nyanekere/GTXR-Mini-Motors-Project/Mini Motors DRM.pdf

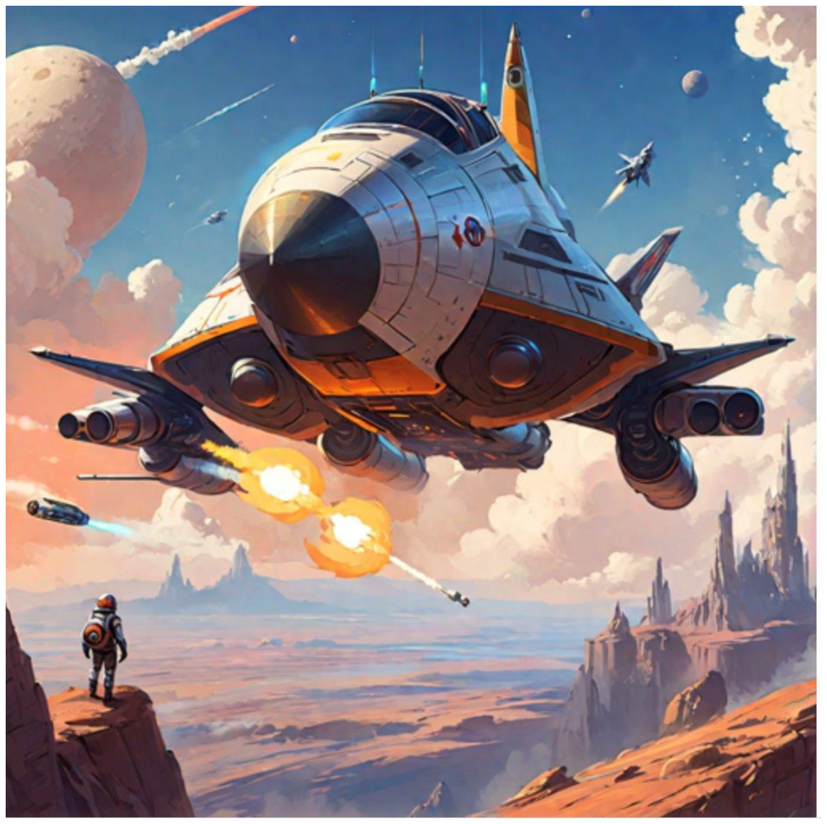
[picture p1: figure]

# Mini Motors DRM – Ride My Rocket

Vedanth Jonnalagadda, Nishu Anekere, Aryan Thacker, Gurnek Singh

# DRM Overview

- Motor Design Requirements
- Major Trades
- Motor Specs - MATLAB Simulation
- Forward Closure
- Head-End Ignition
- Casing
- Nozzle
- Full BOM
- Questions

# Mission

- Create an N-class solid rocket motor design that innovates in terms of retention method, ignition method, and nozzle design to serve as a testbed for future GTXR motor designs.

# Design Requirements

- N-Class Motor
- Maximum Possible Impulse
- Novel Designs: Graphite Nozzle w/ Aluminum Jacket, Head-End Ignition
- In-Depth Analysis
- Good Documentation
- Maximize Wet Mass : Dry Mass Ratio
- Cost < 2k

# Major Trades

- Nozzle: Considered copper, steel, and graphite
oOne-piece nozzle: Chosen for continuity
- Retention Methods: Tried instant pot method, now using radial bolts
- Ignition: Considered black powder
oChose flash powder: larger flame, burns longer

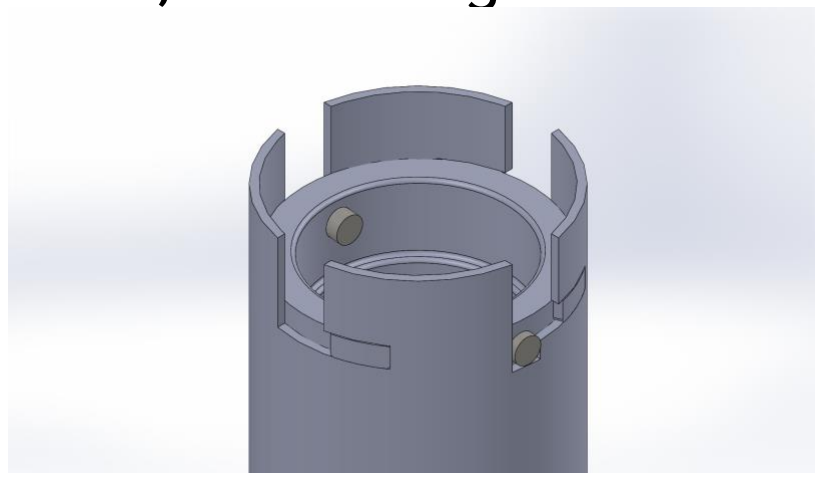
[picture p2: figure]
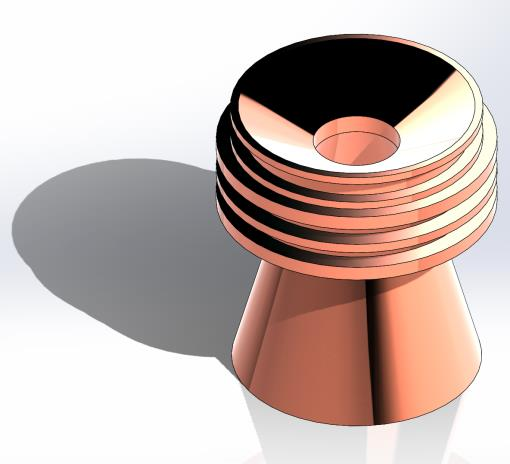
[picture p3: figure]

# Motor CAD Assembly

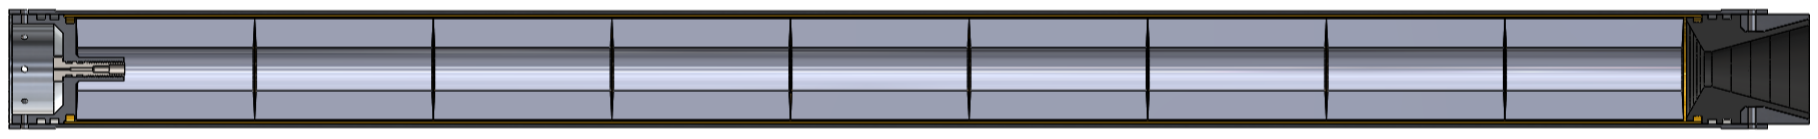
[picture p4: figure]

## Motor Geometry + Specs

- 9 Grains, OD 3.7in
- Total Impulse: 4603 lbf*s
- Max Thrust: 971 lbf
- MEOP: 666 psi
- Propellant Mass: 20.4 lbm

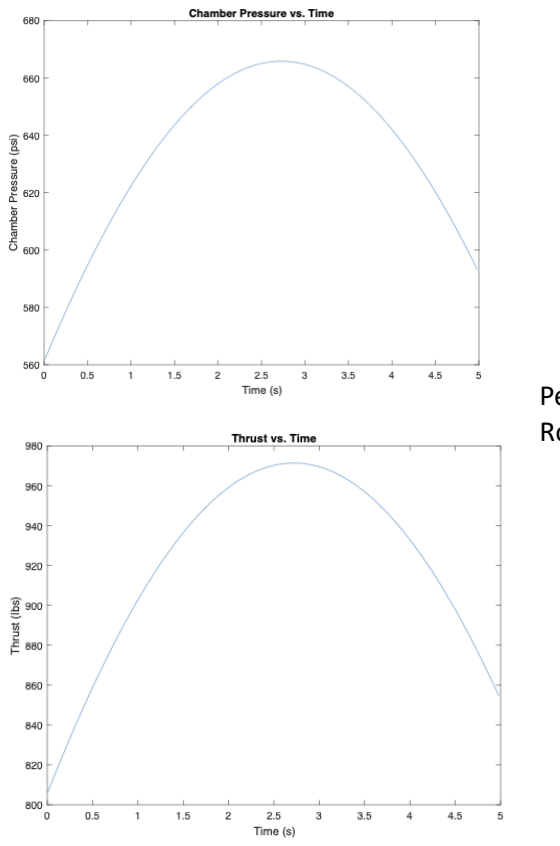
[picture p5: figure]

Peak Ride my
Rocket Team

Maximum Impulse specs generated with optimization script. N-Motor max impulse can be 4604 lbf*s

# Forward Closure – Overview, CAD

## - Design requirements create a high-pressure

seal to withstand extreme pressure.

## - Holes for Pressure Transducer and Igniter

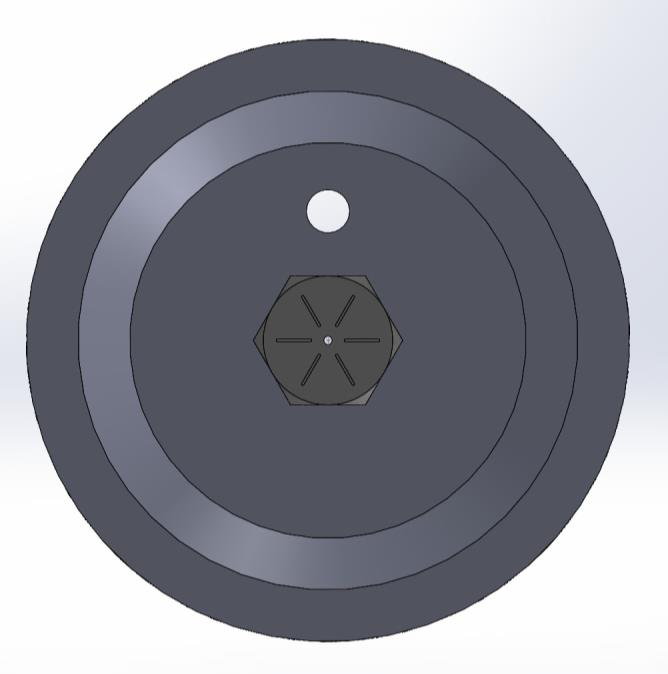
[picture p6: figure]
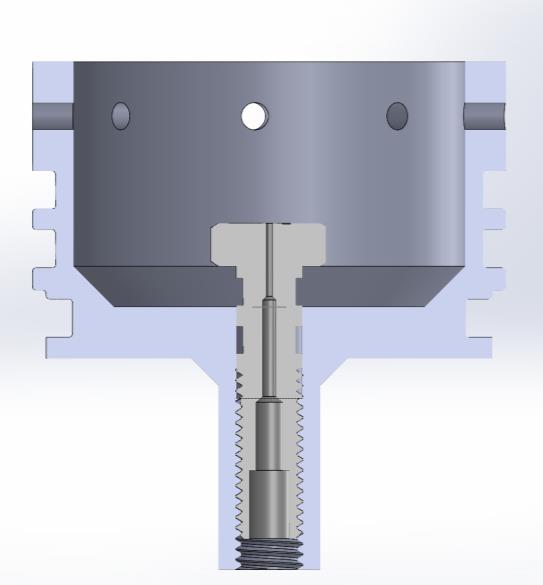
[picture p7: figure]
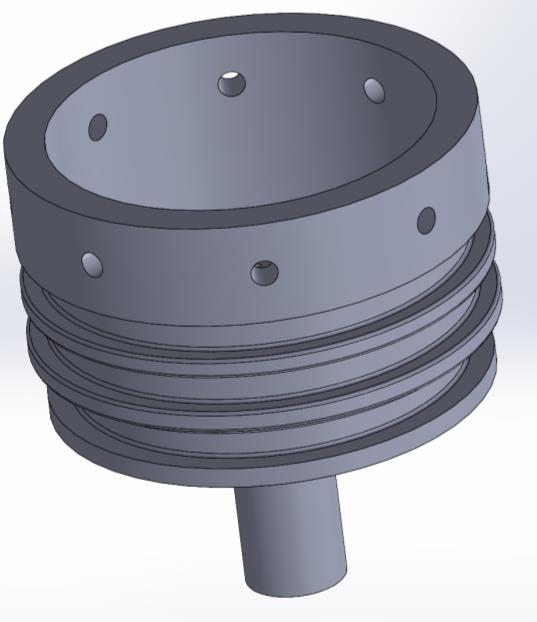
[picture p8: figure]

# Forward Closure – Analysis/ Risk

- Plate Thickness: 0.375 in
oFOS = 2.32
- FWD. Closure Plate stress: 16370 psi
- FOS = 2.3
- 8 Bolt Shear Stress: 727 psi per bolt
- FOS = 9
- Risks

oOverheating leads to the O-rings melting, might lead to leaks

# Forward Closure – Ansys

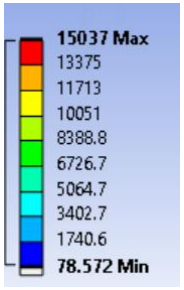
[picture p9: figure]
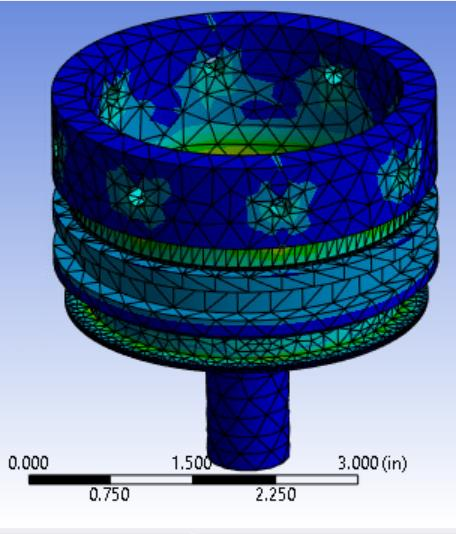
[picture p10: figure]

- Ansys Static Structural
- 5791.6 lb force acting
upwards on bottom face
- Pin holes as fixed
surfaces
- Tensile Strength of Al
6061-T651: 38,000 psi

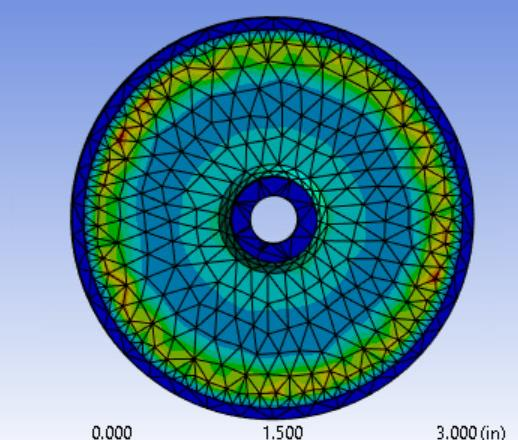
[picture p11: figure]

# Forward Closure – Manufacturing/Integration

- Manufacturing Plan: Simple lathe operations with milling holes and tapping holes
- Grains & thermal liner can be loaded from the top, bolts are used to fasten closure

# Head-End Ignition - Overview

- Design Requirements:
oCreate an igniter that can safely and effectively ignite the motor from the head
oThe igniter must hold back the pressure of the motor and be reusable

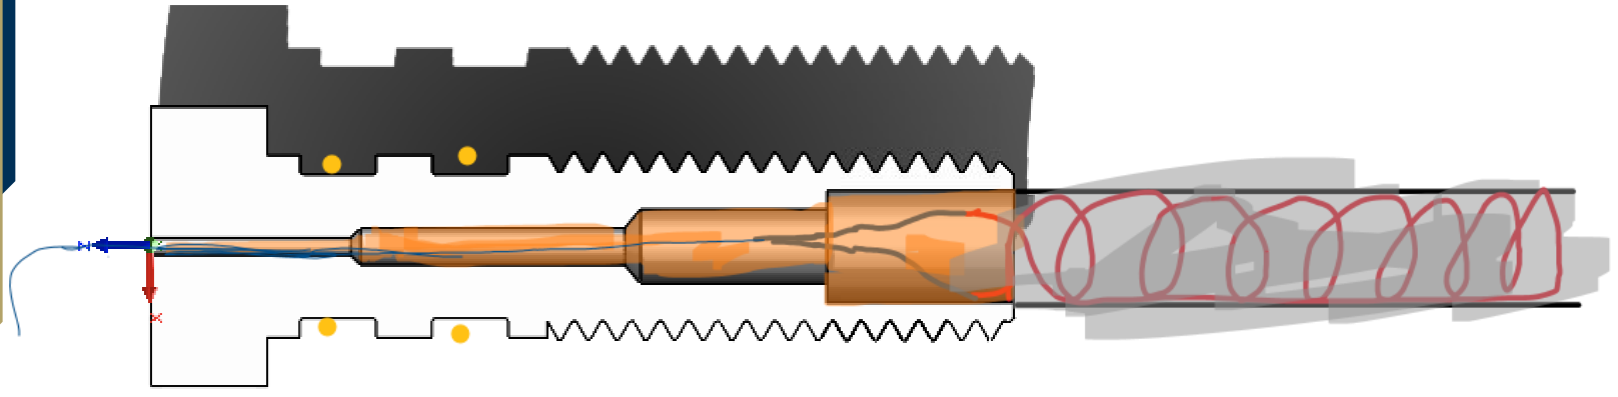
[picture p12: figure]

# Igniter Testing Plan

1. Mix Flash Powder + Quick Setting Epoxy to create sturdy clump
- Flash Powder burns hot and fast while epoxy burns slow
- 60% Potassium Nitrate
- 30% Aluminum Powder
- 10% Sulfur Powder
2. Apply mixture to igniter bolt with nichrome wire wrapped around mesh
3. Adjust flash powder amount increase flame length, wrap nichrome wires and run around 3 amps to ignite.
4.We choose the recipe that generates the greatest flame length and quickest ignition time

# Head-End Ignition – Manufacturing

- Manufacturing, Simple lathe operations on a COTS bolt
- Attach steel mesh to the inside bolt using epoxy
- Wrap Nichrome wire around mesh and attach to another wire that will pass through the tiny hole. Mix the flash powder epoxy and coat onto mesh.

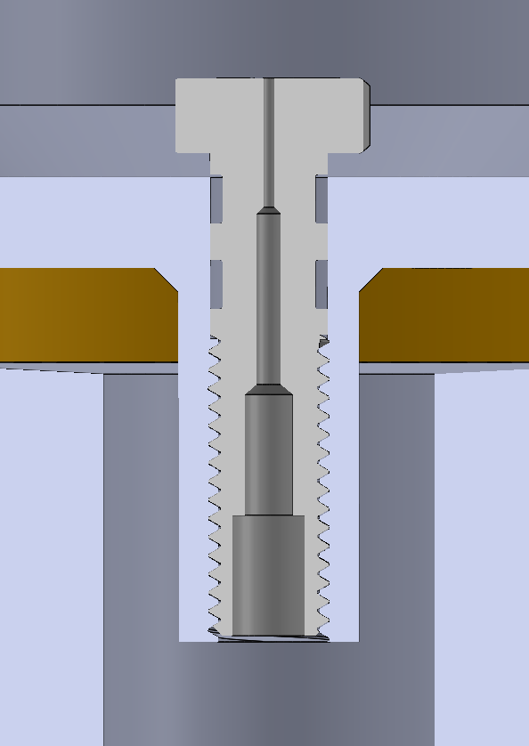
[picture p13: figure]

# Head-End Ignition – Analysis & Risks

- Threads rated for 150,000 psi; Two O-rings rated for 400C
- Nichrome Wire requires 4.5 amps to raise temp to 500C
- The RTV silicone is rated to handle 350 psi, however, based on our design, the silicone should push up against the walls of the bolt since they converge.

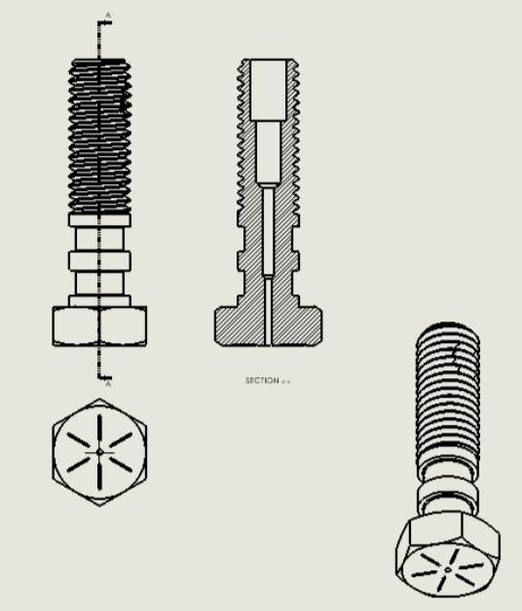
[picture p14: figure]

# Casing – Overview

- Design requirements: contain all the grains, while containing high pressures
- High temp at thermal liner edges lead to vulnerabilities
- Casing Wall Thickness = 0.1" and 0.15" around holes

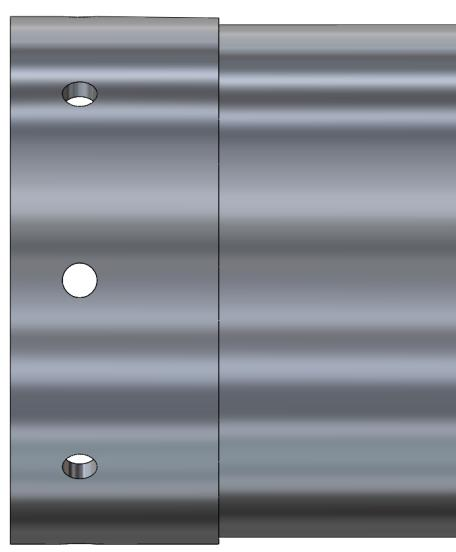
[picture p15: figure]

# Casing – Analysis & Risk

- Hoop Stress: 11700 psi
- FOS = 3
- Longitudinal Stress: 5800 psi
oFOS = 6
- Bearing Stress : 18900 psi
- FOS = 2

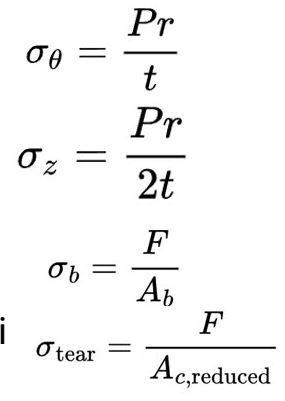
[picture p16: figure]

- Tear-through stress: 3900 psi
- FOS = 9
- High temp at thermal liner edges thermal liner lead to vulnerabilities

# Casing - Manufacturing

- Manufacturing: Lathe OD down and add radial holes with Mill

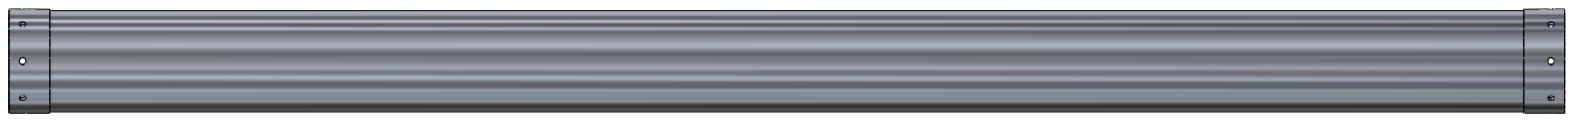
[picture p17: figure]

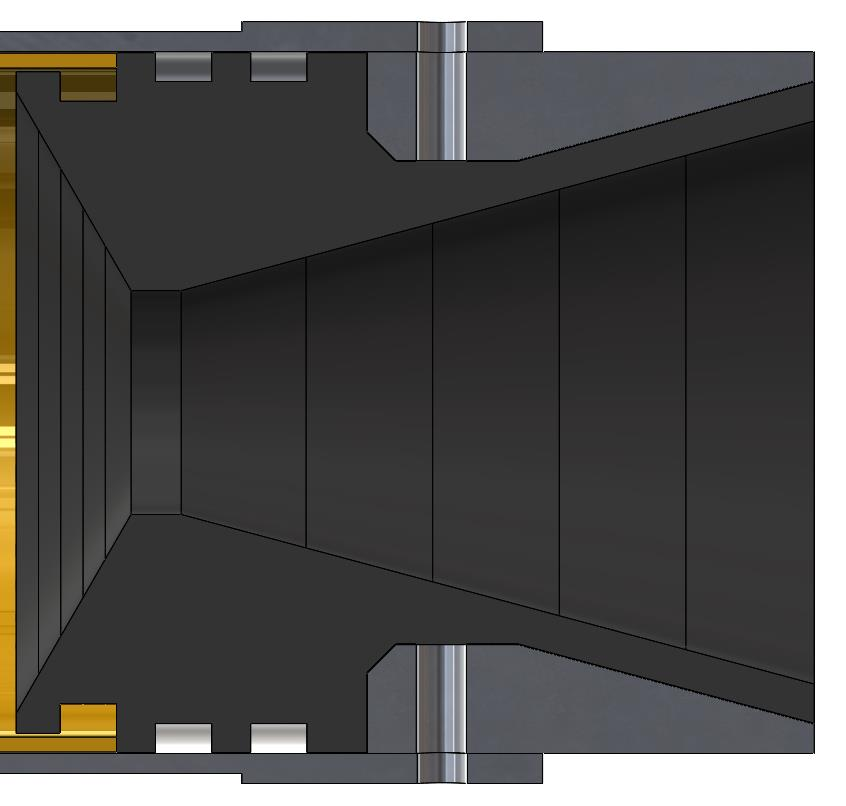
[picture p18: figure]

# Nozzle - Overview/Risks

- Two-Part Nozzle – insert CAD
oFull Graphite Contour
oAluminum Jacket w/ Radial Bolts
- Jacket is cut in half to insert onto the nozzle
- Liner Interface
- Risks
oAluminum Melting
oGraphite Cracking

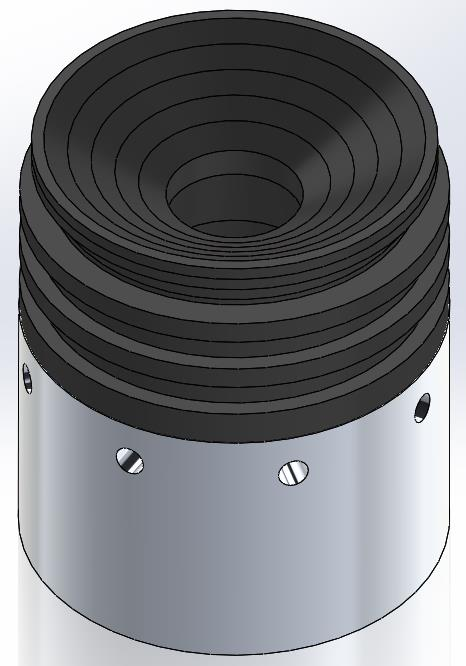
[picture p19: figure]

# Heat Transfer Methodology

- Bartz Equation [1] gives heat transfer coefficient and is accurate for nozzle heat transfer as per NASA paper + Connor has used it before
- Wrote code to graph h_g vs. Nozzle Distance + pulled properties from CEA and Nozzle Geometry
- Input heat transfer coefficient into ANSYS

## Verifying Heat Transfer Code w/ NASA Paper

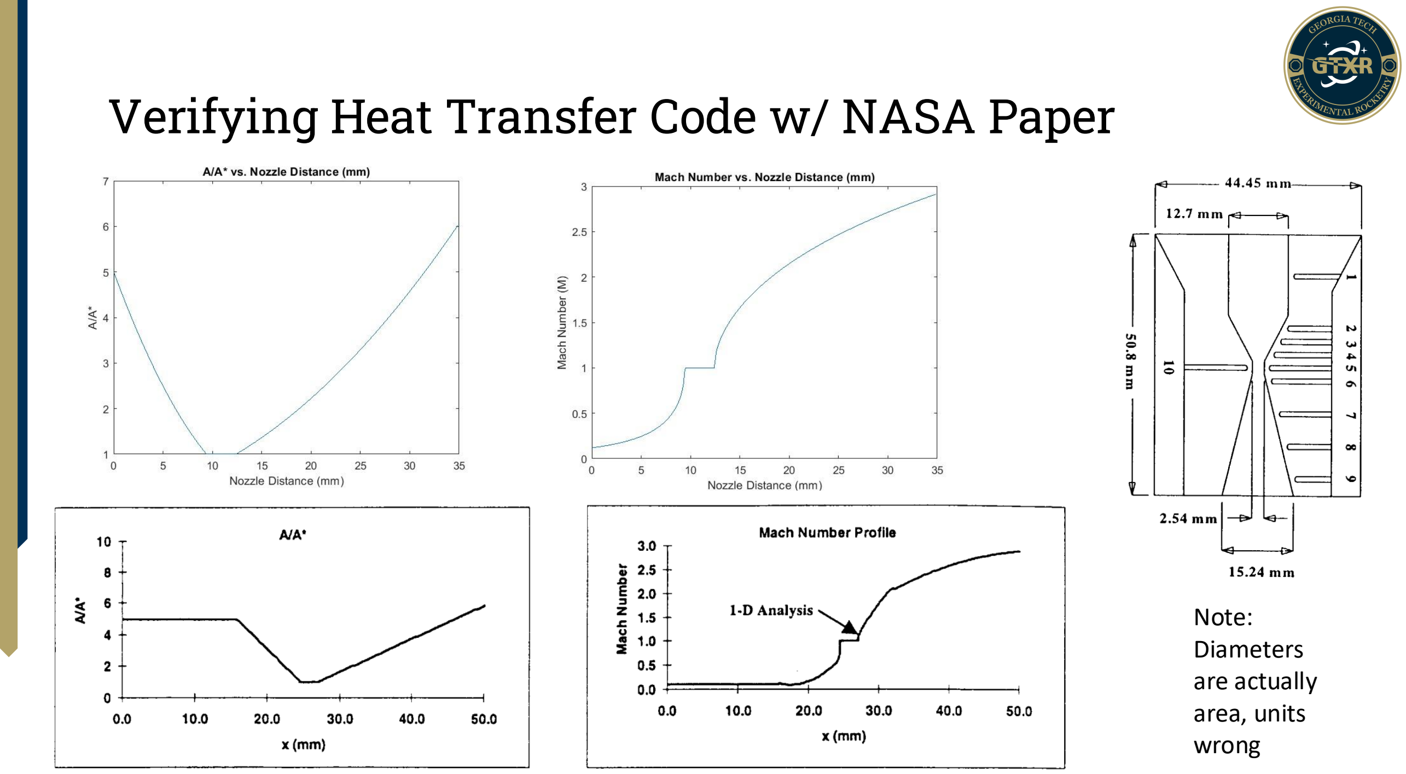
[picture p20: page 21]

Note:
Diameters
are actually
area, units
wrong

# Verifying Code (cont.)

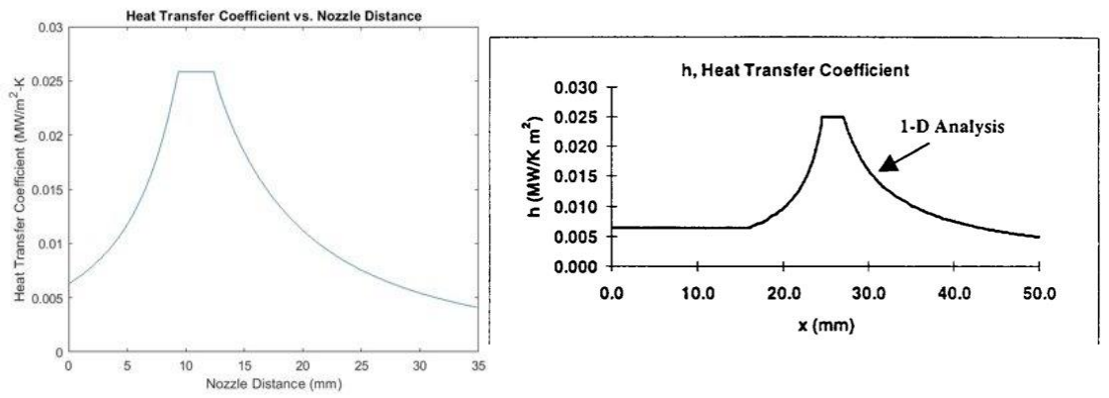
[picture p21: figure]

## Heat Transfer Graphs

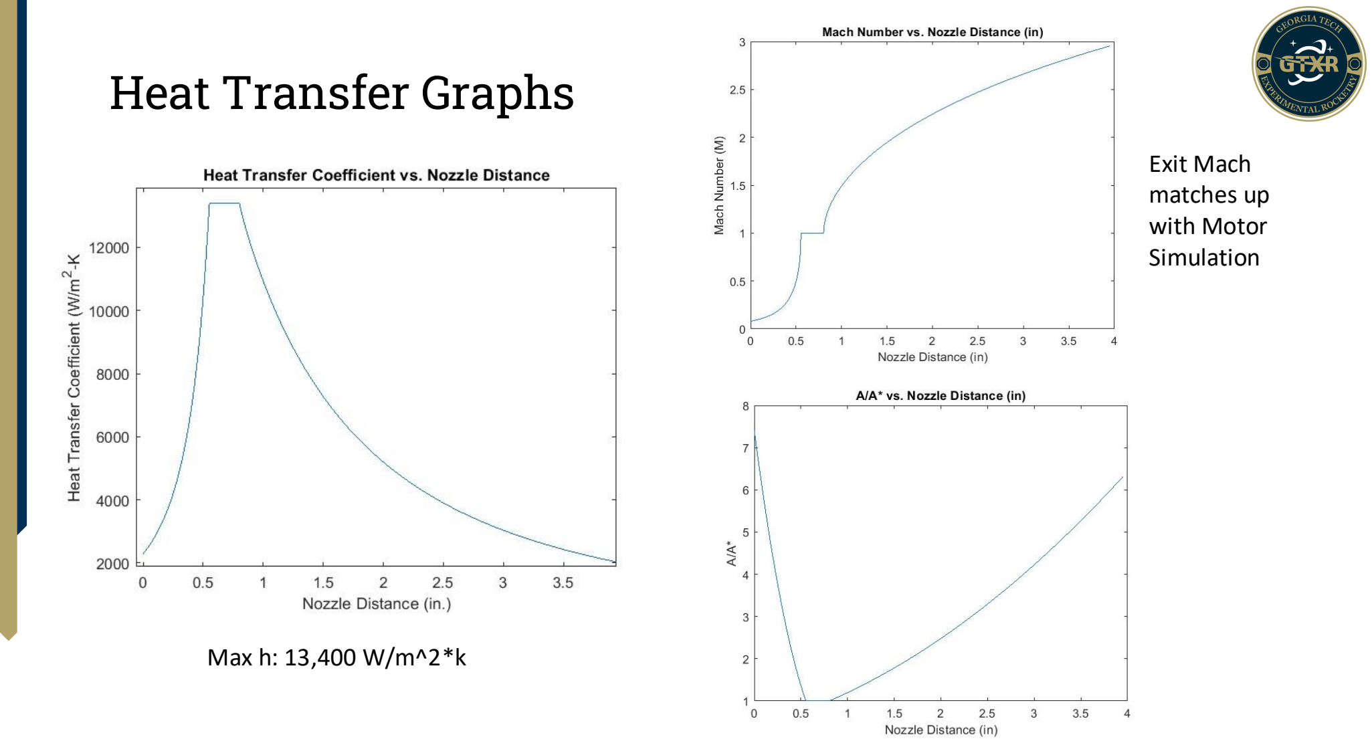
[picture p22: page 23]

Max h: 13,400 W/m^2*k

Exit Mach
matches up
with Motor
Simulation

# Nozzle – Analysis (Transient Thermal)

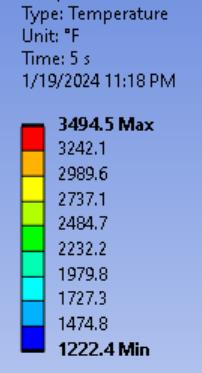
[picture p23: figure]

- Heat transfer into nozzle: mainly convection, others ignored
- ANSYS Transient Thermal Analysis
- Boundary Conditions: Sliced nozzle,
took weighted avg's of corresponding
sections of Heat Transfer Coeff. Vs. Nozzle Distance and assigned to each slice
- Graphite Melting Temp: 5000 F
- Aluminum Melting Temp: 1221 F

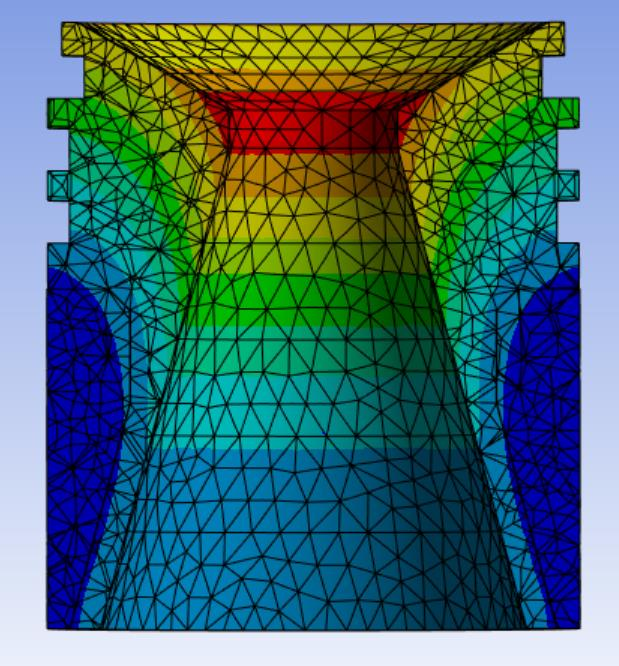
[picture p24: figure]
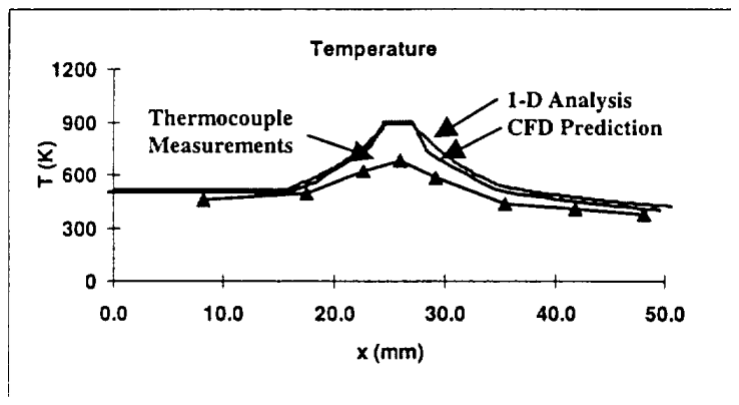
[picture p25: figure]

# Nozzle – Analysis (Structural Analysis)

- ANSYS Structural Analysis – Nozzle Compressive + Hoop Stresses
- Max stress disregarded (bad mesh around
bolt holes)
- Nozzle Ring Bearing Stress
- Bolts Stresses
- Graphite Nozzle FOS = 1.9 ~ 2
- (Compressive Yield Stress)
- Aluminum Jacket FOS = 11.8
- (Tensile Yield Stress)

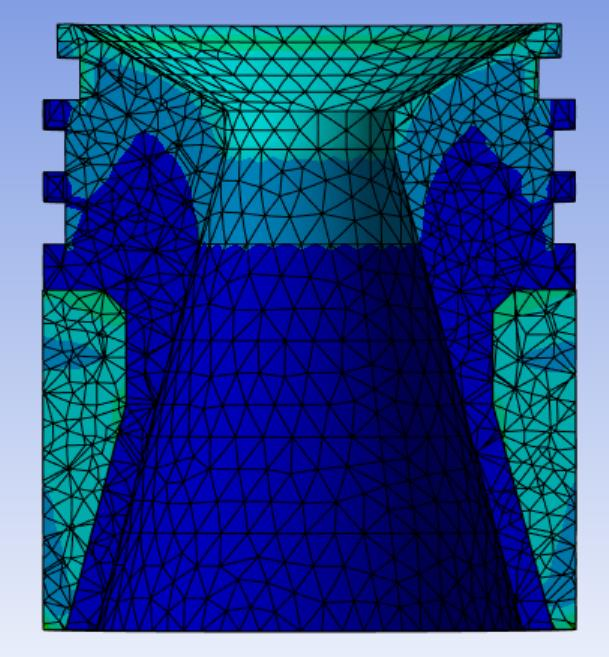
[picture p26: figure]
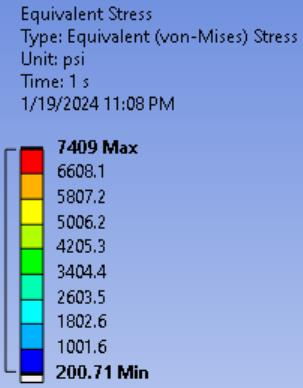
[picture p27: figure]

# Nozzle – Manufacturing/Integration/Cost

- Graphite Contour can be manufactured with a Lathe
- Aluminum Jacket can be manufactured with the Lathe, Mill, and Wire EDM or Waterjet
- Clamp both pieces of the Aluminum Jacket onto the graphite, slide into motor, attach bolts

# Motor BOM

- Full Cost- $623
- Fwd. Closure Cost : $80
- Igniter Cost :$170
oCasing Cost - $260
oNozzle Cost - $130
- Link to full BOM (https://gtvault.sharepoint.com/:x:/r/sites/ridemyrocket/_layouts/15/Doc.aspx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)

# Closing Remarks

- Shoutout Andrew for answering all our questions and Connor for helping with the heat transfer!
- All CAD, calculations, graphs, trade studies found in
our SharePoint (https://gtvault.sharepoint.com/sites/ridemyrocket/Shared%20Documents/Forms/AllItems.aspx)
- Why should we be picked?
- Novel Nozzle, Igniter Desings
- Maximum Impulse for N-Motor
- In-Depth Analysis
- Cheap

# Questions?

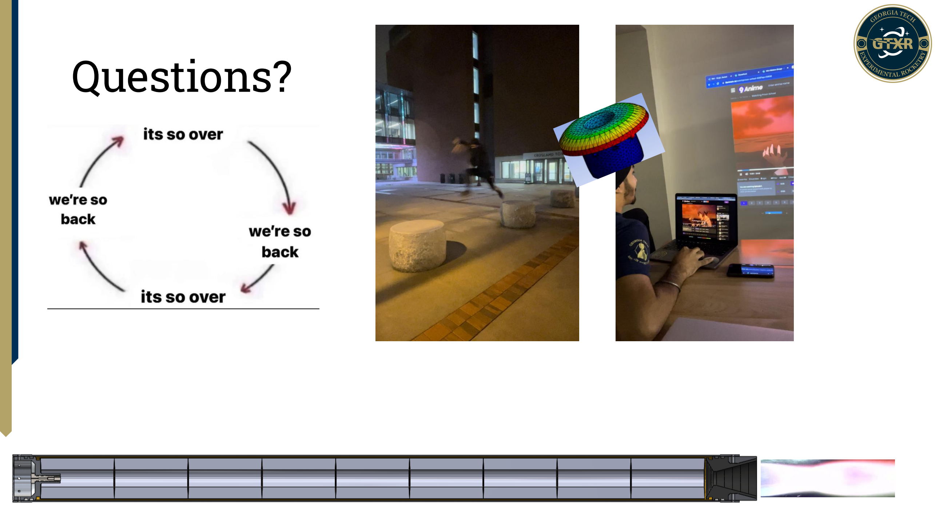
[picture p28: page 29]

# References

- Nozzle Heat Transfer NASA Paper -https://ntrs.nasa.gov/api/citations/19990025912/downloads/19990025912.pdf (https://ntrs.nasa.gov/api/citations/19990025912/downloads/19990025912.pdf) [1]
