nyanekere/GTXR-Mini-Motors-Project/Copper Nozzle V2 (7).SLDPRT

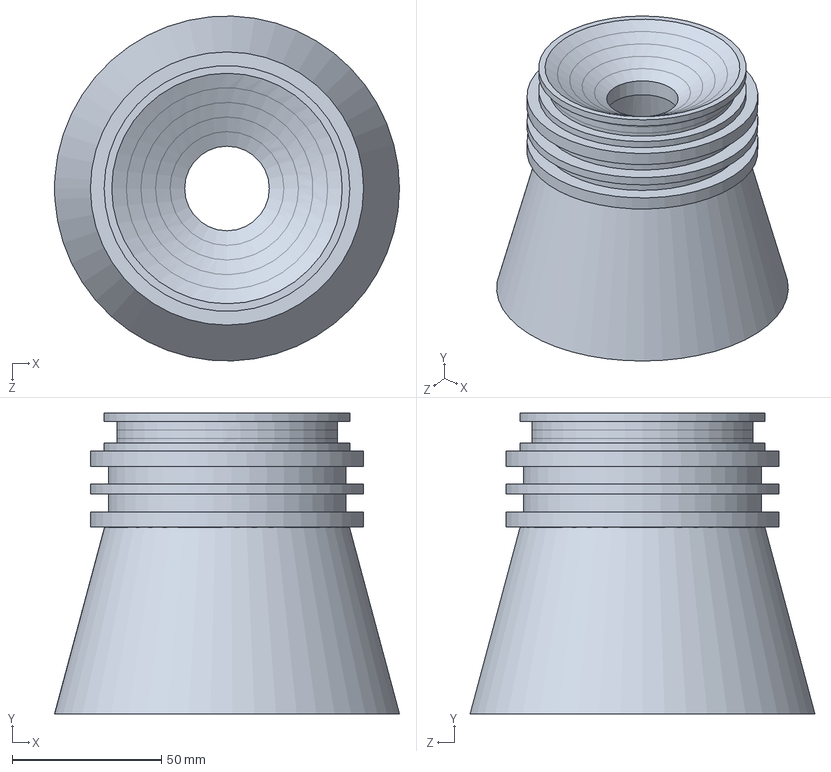
[picture p29: CAD file, 2025-10-03]
Copper Nozzle V2 (7).SLDPRT
115.5 x 100.6 x 115.5 mm
