nyanekere/GTXR-Mini-Motors-Project/Copper Nozzle Cavity.SLDPRT

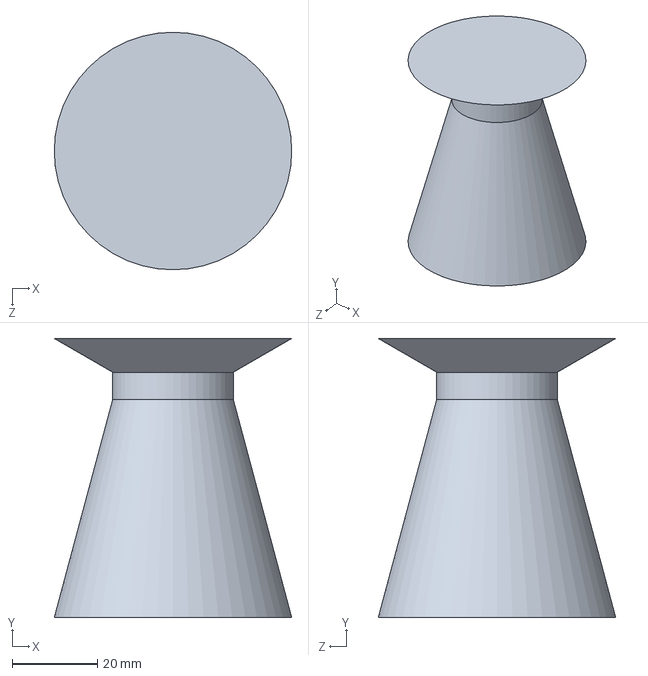
[picture p30: CAD file, 2025-10-03]
Copper Nozzle Cavity.SLDPRT
55.9 x 65.6 x 55.9 mm
