nyanekere/GTXR-Mini-Motors-Project/Nozzle Heat Tranfer ANSYS Results (Screenshots).pdf

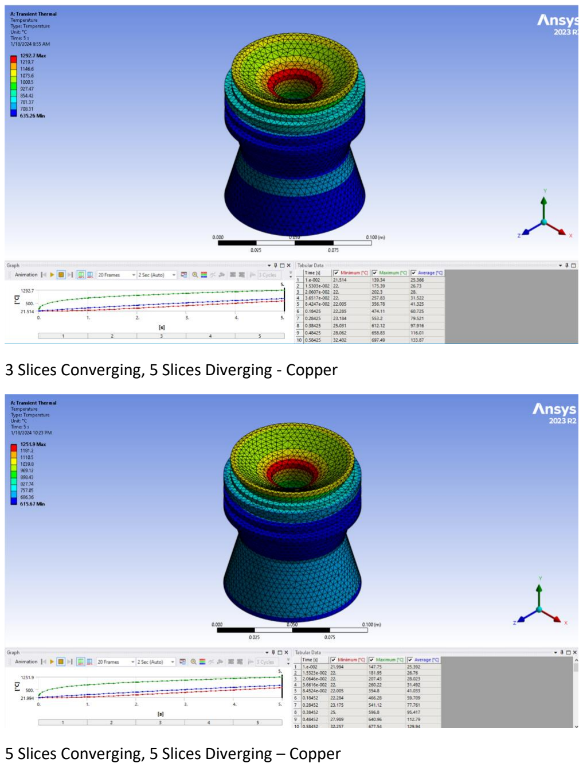
[picture p31: page 1]

3 Slices Converging, 5 Slices Diverging - Copper

5 Slices Converging, 5 Slices Diverging – Copper

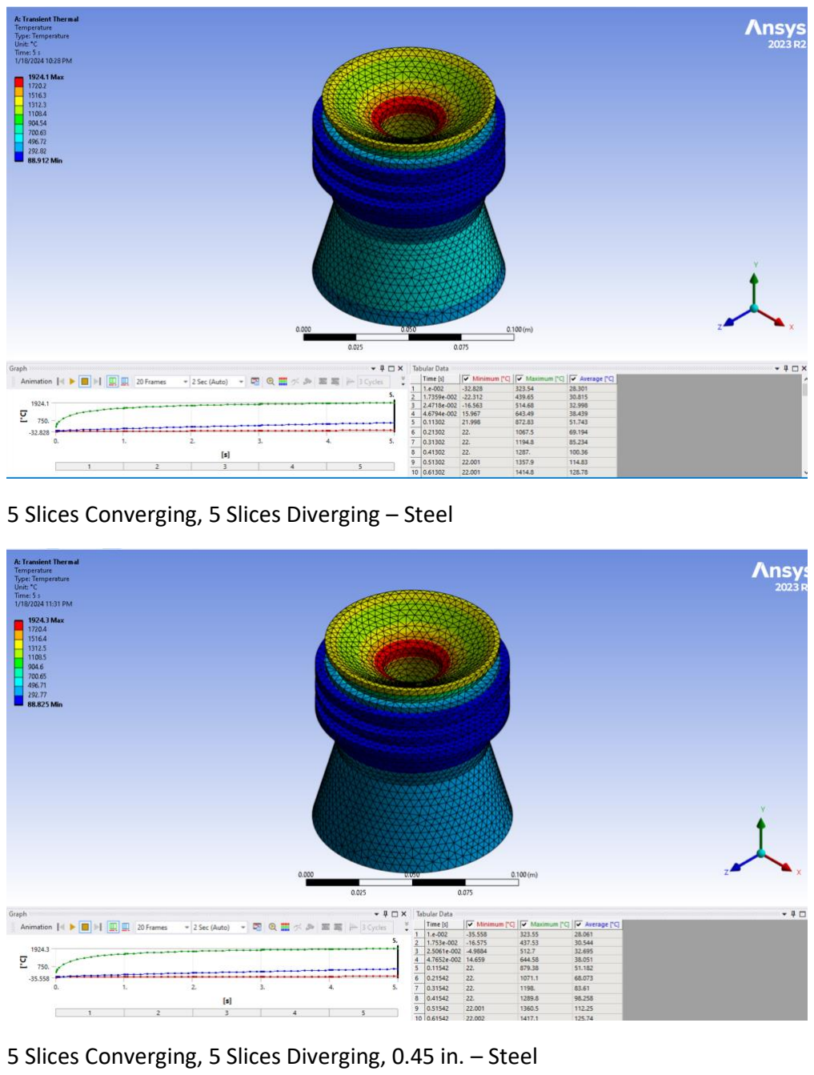
[picture p32: page 2]

5 Slices Converging, 5 Slices Diverging – Steel

5 Slices Converging, 5 Slices Diverging, 0.45 in. – Steel

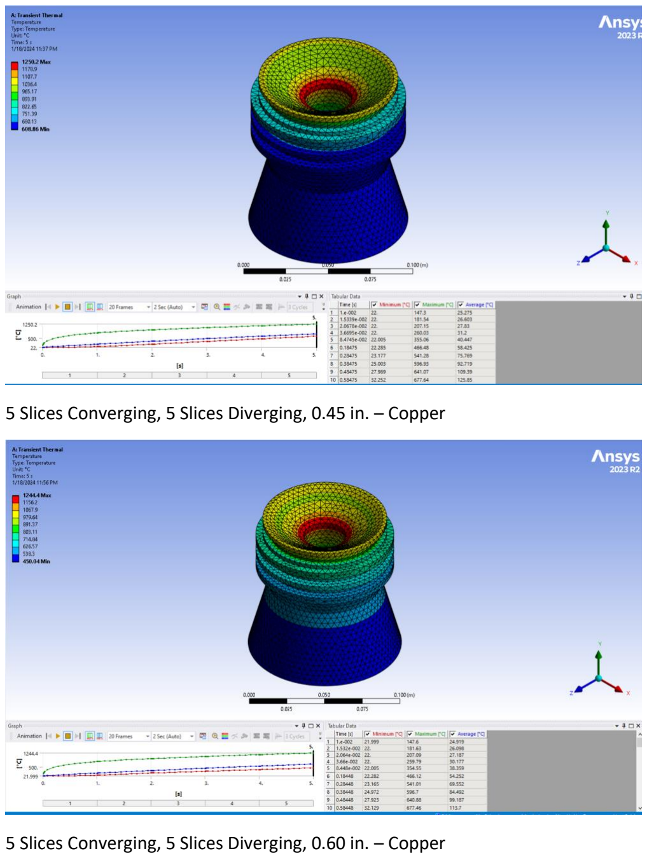
[picture p33: page 3]

5 Slices Converging, 5 Slices Diverging, 0.45 in. – Copper

5 Slices Converging, 5 Slices Diverging, 0.60 in. – Copper

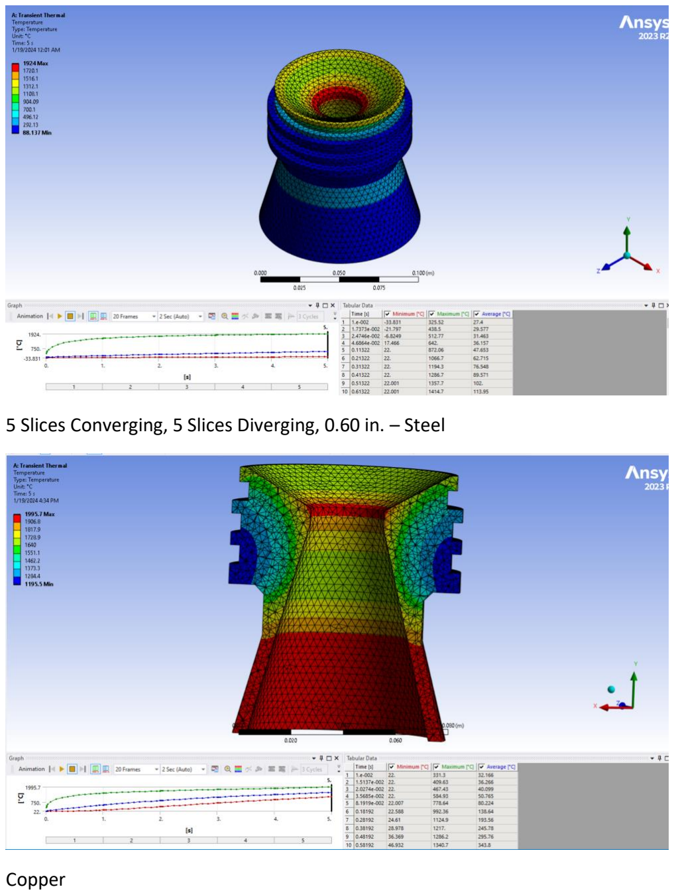
[picture p34: page 4]

5 Slices Converging, 5 Slices Diverging, 0.60 in. – Steel

Copper
