nyanekere/GTXR-Mini-Motors-Project/(commit log)

2025-10-03 CAD Files of Nozzle Designs analyzed using transient heat analysis in ANSYS Mechanical
    [Copper Nozzle Cavity.SLDPRT, Copper Nozzle V2 (7).SLDPRT]
2025-10-03 Documentation of ANSYS Nozzle Transient Thermal Analysis
    Documents iterative approach to "slicing" copper and steel nozzle designs in SolidWorks, performing transient thermal analysis, observing temperature distribution across nozzle designs, and iterating on slices taken and nozzle thickness.
2025-10-03 MATLAB scripts used to optimize specific impulse of N-class solid rocket motor based on isentropic relations
